VladimirMukhin21/Totoshka/Arduino MEGA распиновка.jpg

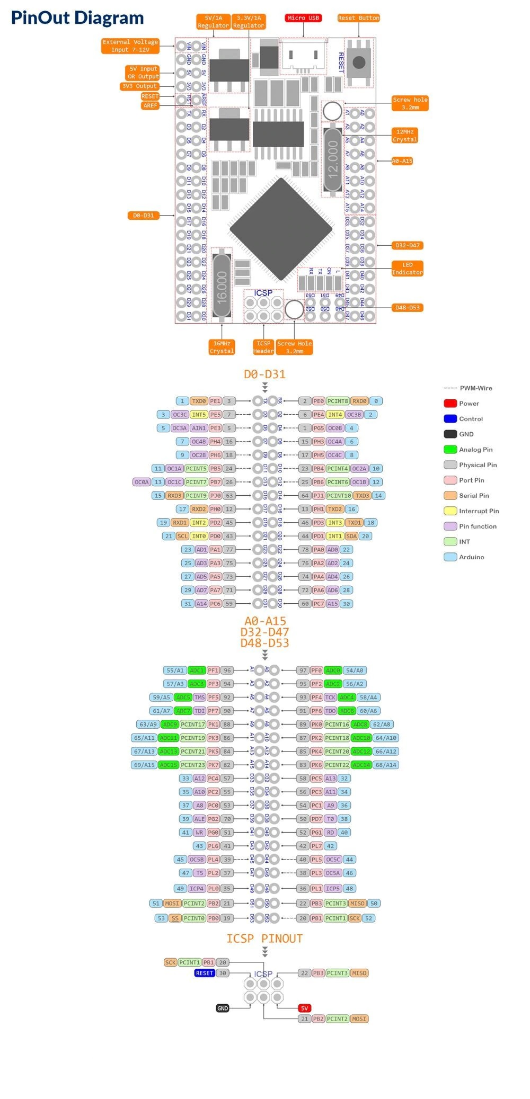
Arduino MEGA распиновка.jpg
