VladimirMukhin21/Totoshka/Инструменты с собой/IMG_20221014_193917.jpg

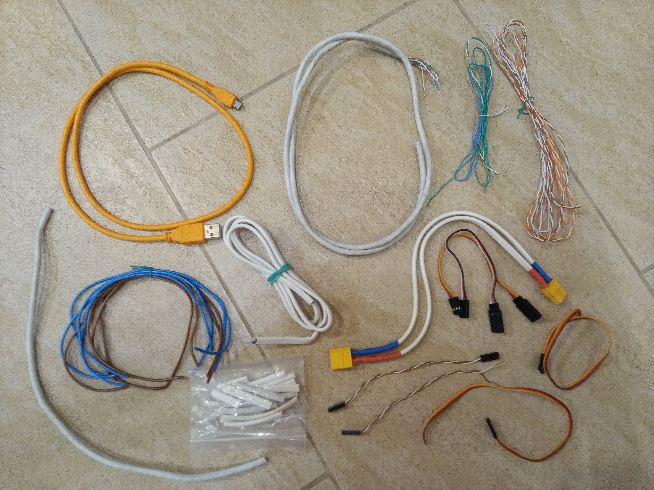
Инструменты с собой/IMG_20221014_193917.jpg
