VladimirMukhin21/Totoshka/src/Camera/samples/amox.png

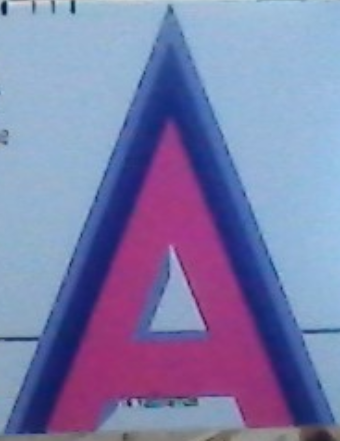
src/Camera/samples/amox.png
