VladimirMukhin21/Totoshka/src/Camera/samples/left.png

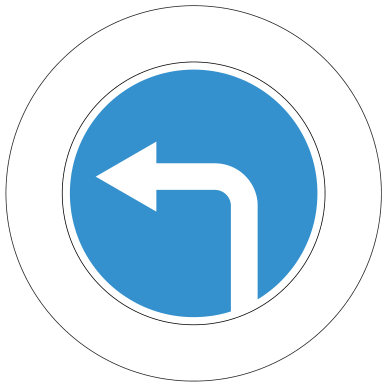
src/Camera/samples/left.png
