VladimirMukhin21/Totoshka/src/Camera/samples/right.png

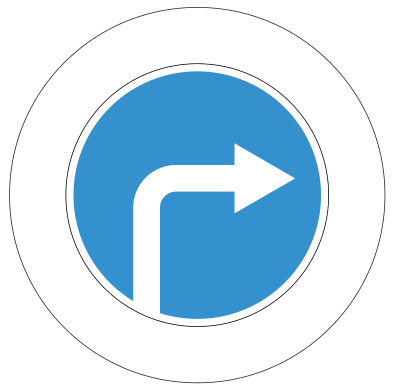
src/Camera/samples/right.png
