VladimirMukhin21/Totoshka/src/Camera/samples/stop.png

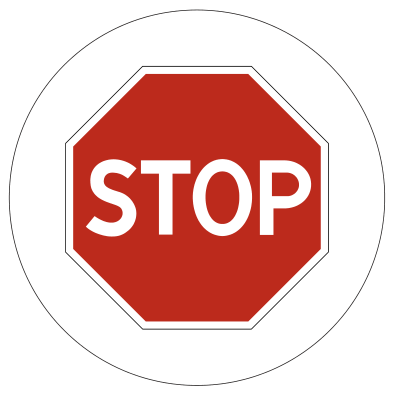
src/Camera/samples/stop.png
