VladimirMukhin21/Totoshka/src/traffic-signs/all.png

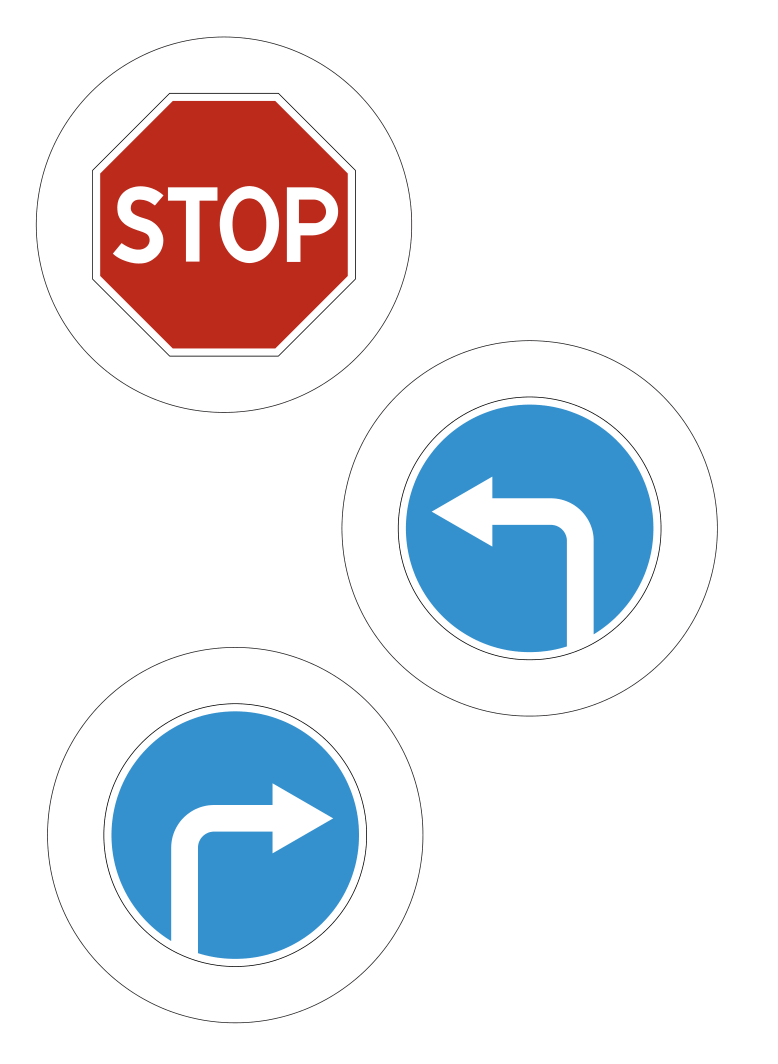
src/traffic-signs/all.png
