VladimirMukhin21/Totoshka/src/traffic-signs/left-for-detect.png

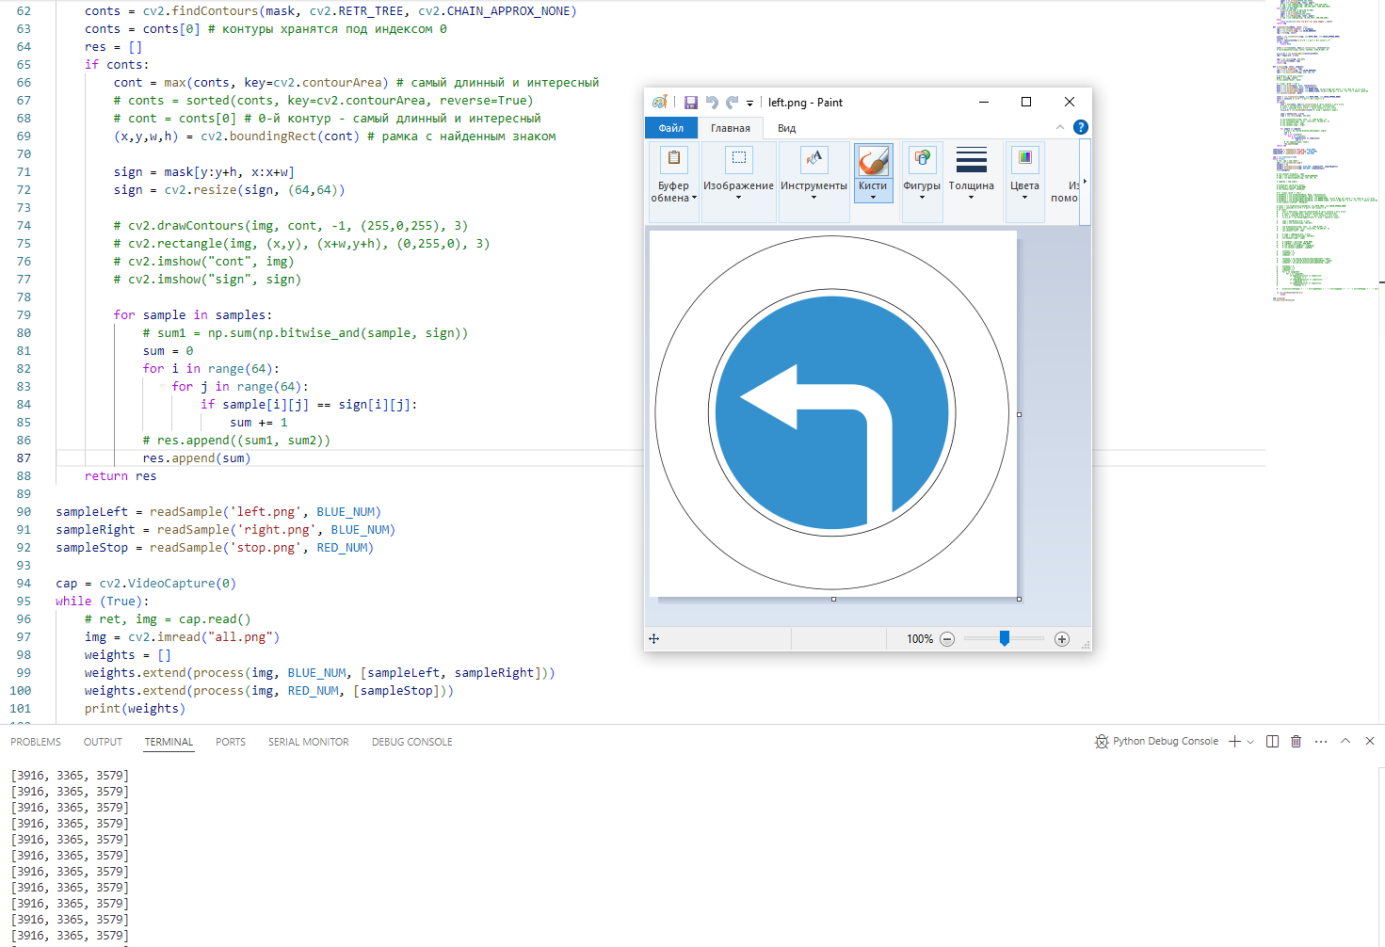
src/traffic-signs/left-for-detect.png
