VladimirMukhin21/Totoshka/Инструменты с собой/IMG_20211210_194941.jpg

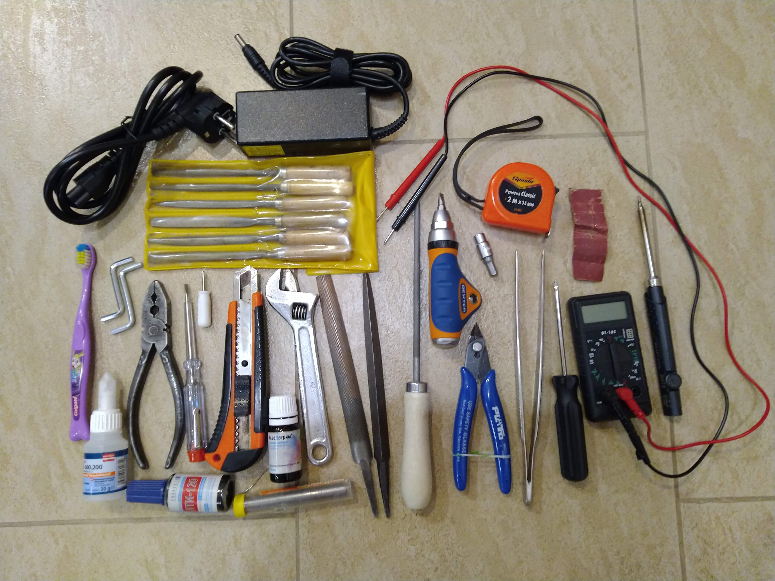
Инструменты с собой/IMG_20211210_194941.jpg
