VladimirMukhin21/Totoshka/Инструменты с собой/IMG_20211210_200247.jpg

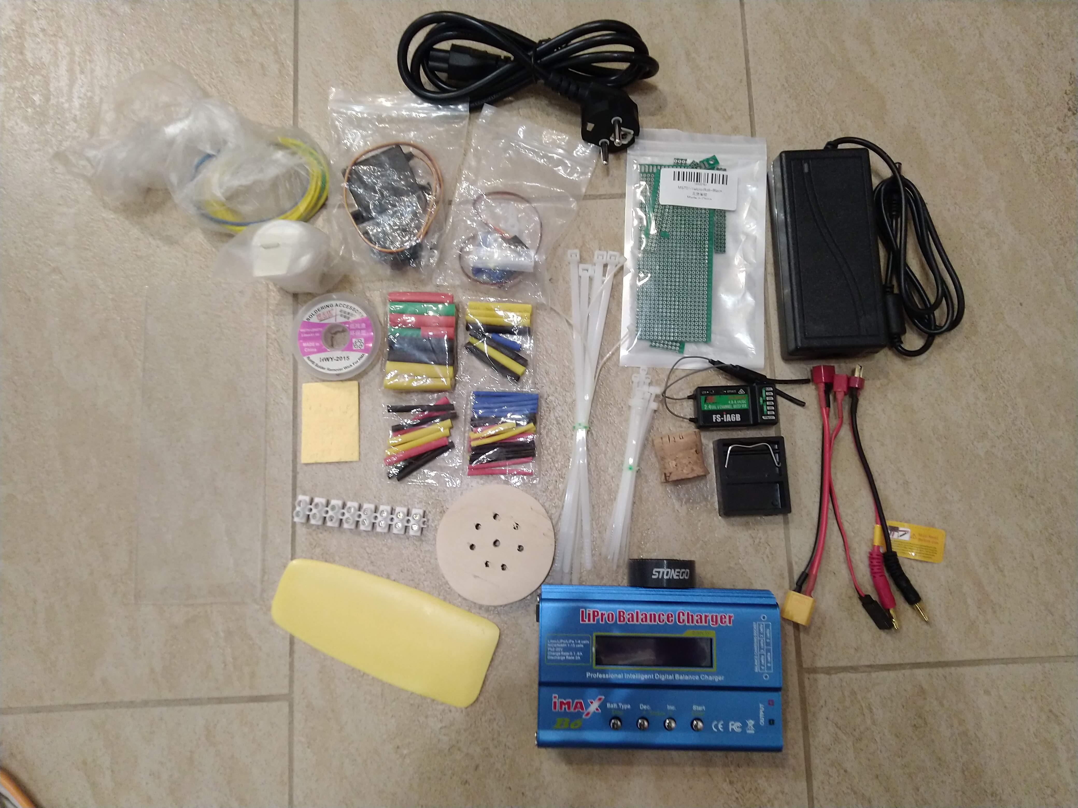
Инструменты с собой/IMG_20211210_200247.jpg
