VladimirMukhin21/Totoshka/Инструменты с собой/IMG_20211210_202206.jpg

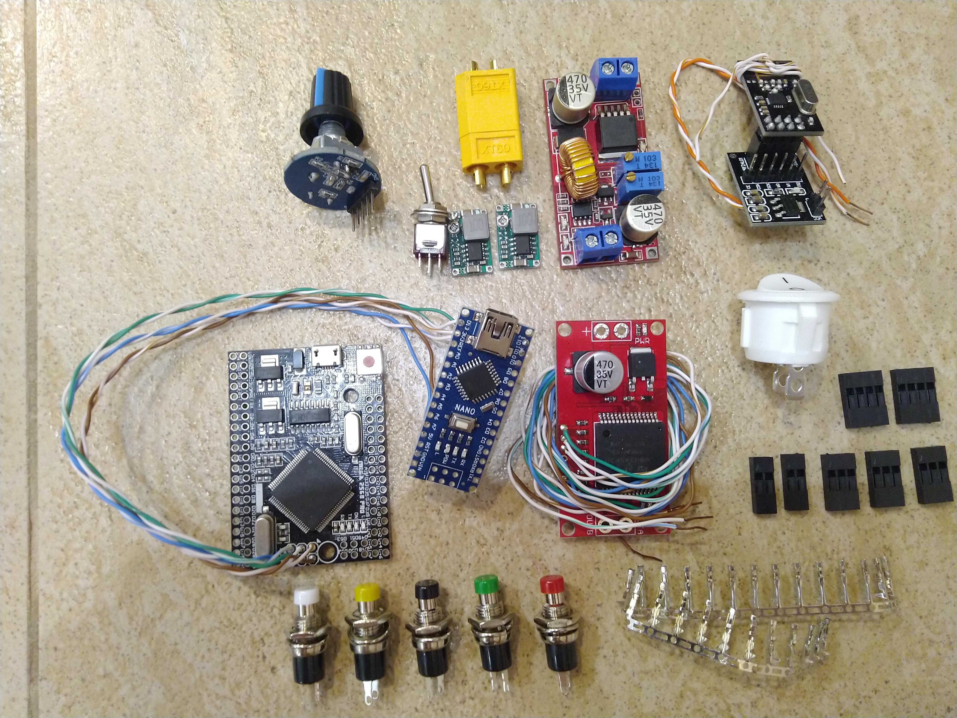
Инструменты с собой/IMG_20211210_202206.jpg
