VladimirMukhin21/Totoshka/Инструменты с собой/IMG_20211210_204245.jpg

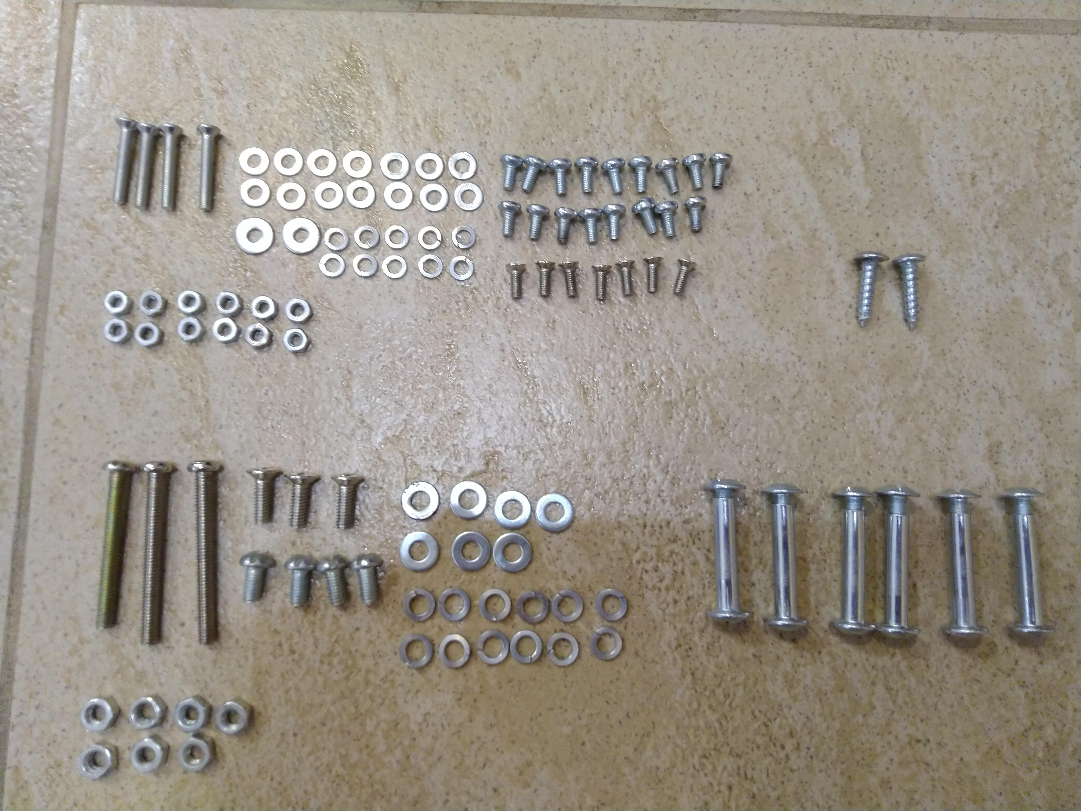
Инструменты с собой/IMG_20211210_204245.jpg
