VladimirMukhin21/Totoshka/Инструменты с собой/IMG_20211210_204258.jpg

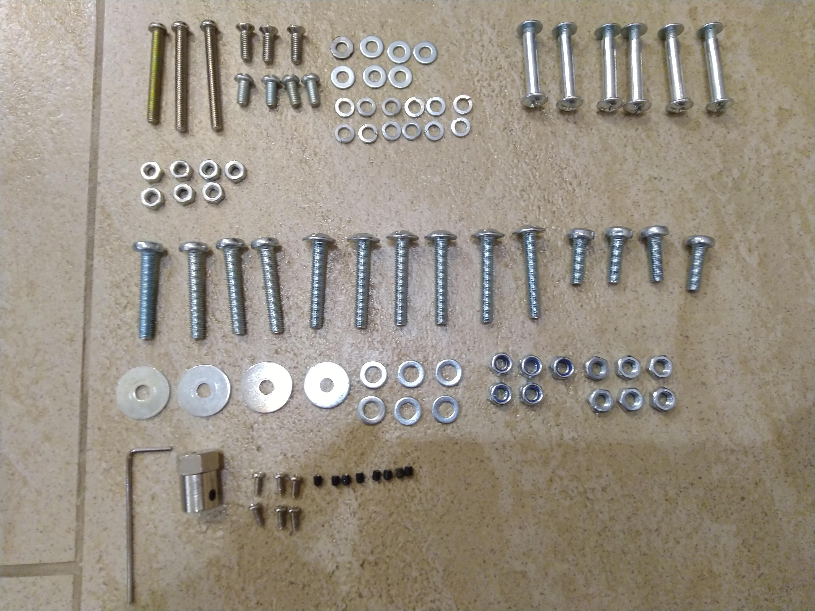
Инструменты с собой/IMG_20211210_204258.jpg
