VladimirMukhin21/Totoshka/Инструменты с собой/IMG_20221014_192934.jpg

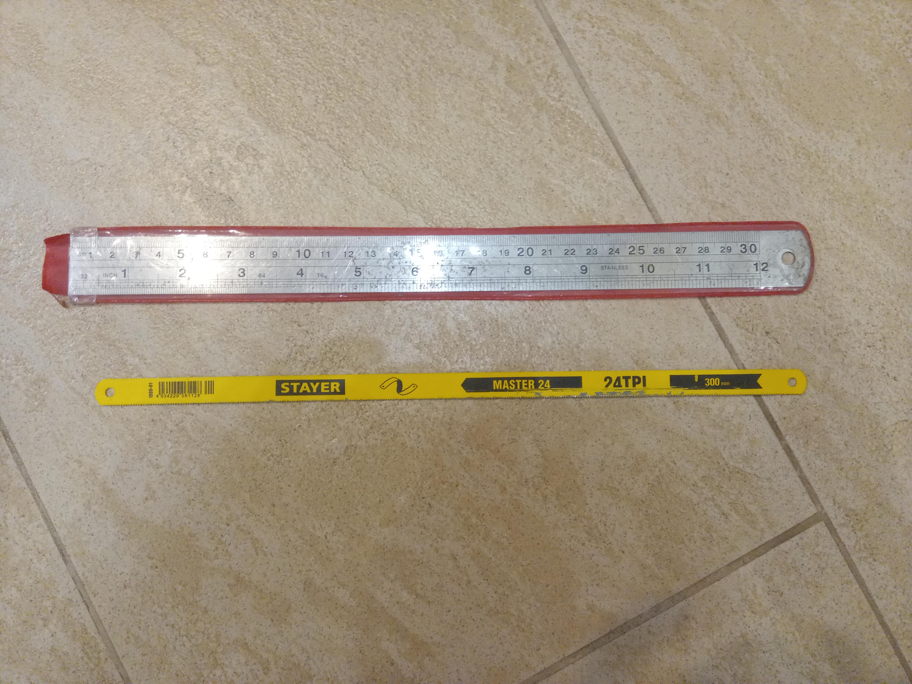
Инструменты с собой/IMG_20221014_192934.jpg
