VladimirMukhin21/Totoshka/Инструменты с собой/IMG_20221014_202028.jpg

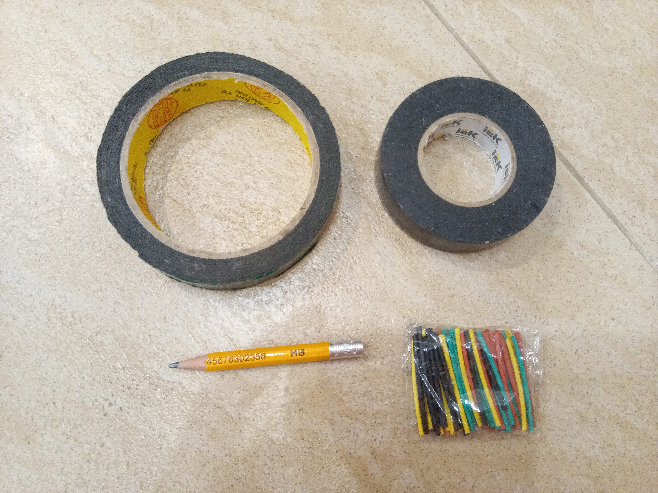
Инструменты с собой/IMG_20221014_202028.jpg
