VladimirMukhin21/Totoshka/Инструменты с собой/IMG_20221014_202440.jpg

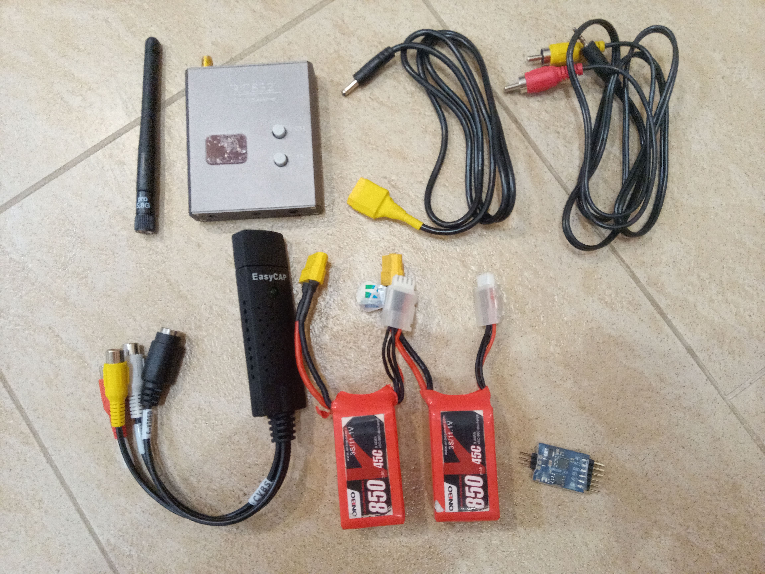
Инструменты с собой/IMG_20221014_202440.jpg
