VladimirMukhin21/Totoshka/Инструменты с собой/IMG_20221129_160802.jpg

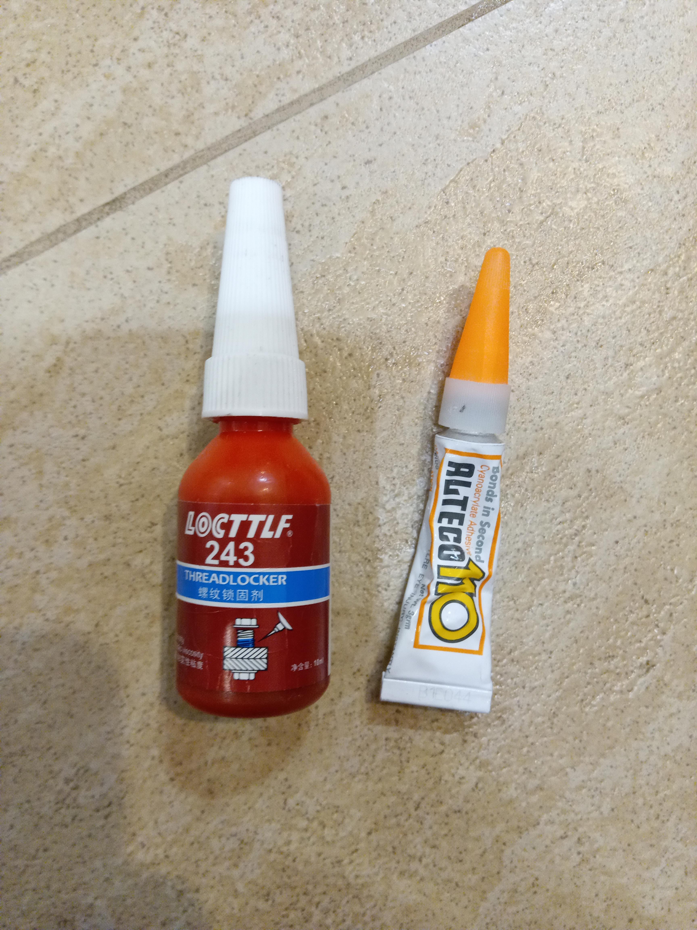
Инструменты с собой/IMG_20221129_160802.jpg
