VladimirMukhin21/Totoshka/Расчет робота.xlsx

Sheet: Лист1
Диаметр колеса, мм | 75 | 100 | 125 | 130
Длина окружности колеса, м | 0.235 | 0.314 | 0.393 | 0.408
Скорость рабочая
Скорость, м/с | 0.40 | 0.40 | 0.40 | 0.40
Скорость, м/мин | 24 | 24 | 24 | 24
Обороты вала, об/мин | 101.910828 | 76.43312102 | 61.14649682 | 58.79470848
Скорость минимальная
Скорость, м/с | 0.01 | 0.01 | 0.01 | 0.01
Скорость, м/мин | 0.60 | 0.60 | 0.60 | 0.60
Обороты вала, об/мин | 2.5 | 1.9 | 1.5 | 1.5
Скорость максимальная
Скорость, м/с | 0.75 | 0.75 | 0.75 | 0.75
Скорость, м/мин | 45 | 45 | 45 | 45
Обороты вала, об/мин | 191.0828025 | 143.3121019 | 114.6496815 | 110.2400784
Масса робота, кг | 5.4 | 5.4 | 5.4 | 5.4
Запас по мощности | 20% | 20% | 20% | 20%
Крутящий момент (3 двиг), кг*см | 8.1 | 10.8 | 13.5 | 14.0 | при жесткой подвеске робот будет касаться только 3-мя колесами
Крутящий момент (4 двиг), кг*см | 6.1 | 8.1 | 10.1 | 10.5
Крутящий момент (6 двиг), кг*см | 4.0 | 5.4 | 6.8 | 7.0

Sheet: Лист2
+ | Серва 60кг со скобами
+ | Серва 25кг 2шт со скобами
+ | Серва 15кг 2шт
+ | ATmega2560 2шт
+ | nNRF24L01 с антенной 2шт + стабилизатор питания
+ | Джойстик 2шт
+ | Энкодер
+ | Кпопка
 | линия 3шт
 | дальномер
 | Акселерометр-гироскоп
- | столбики
+ | регулятор питания
+ | макетная плата
- | провода мягкие
 | коробка для пульта и робота

Sheet: Пины
Распиновка Mega Пульт |  |  |  |  |  |  |  |  |  |  |  | Общая шина +/-
подключено | цвет | пин | пин | цвет | подключено | подключено | цвет | пин | пин | цвет | подключено | подключено | + | - | подключено | - | подключено
 |  | D1 tx | D0 rx |  |  |  |  | A1 | A0 |  |  |  | + | - |  | -
 |  | D3~ | D2~ |  |  |  |  | A3 | A2 |  |  |  | + | - |  | -
 |  | D5~ | D4~ |  |  |  |  | A5 | A4 |  |  |  | + | - |  | -
 |  | D7~ | D6~ |  |  |  |  | A7 | A6 |  |  |  | + | - |  | -
 |  | D9~ | D8~ |  |  |  |  | A9 | A8 |  |  |  | + | - |  | -
 |  | D11~ | D10~ |  |  |  |  | A11 | A10 |  |  |  | + | - |  | -
 |  | D13~ | D12~ |  |  | джойстик лев верт | БЗ | A13 | A12 | БЗ | джойстик прав верт | джойстик прав | + | - | джойстик прав | -
 |  | D15 | D14 |  |  | джойстик лев гориз | З | A15 | A14 | З | джойстик прав гориз | джойстик лев | + | - | джойстик лев | -
KeyPad R3 | СЕР | D17 | D16 | СЕР | KeyPad R4 | джойстик-кнопка лев | О | D33 | D32 | О | джойстик-кнопка прав | Mega + NRF | + | - | Mega + NRF | - | зелёная кнопка
KeyPad R1 | СЕР | D19 | D18 | СЕР | KeyPad R2 |  |  | D35 | D34 |  |  | включатель питания | + | - | включатель питания | - | синяя кнопка
KeyPad C2 | СЕР | D21 | D20 | СЕР | KeyPad C1 |  |  | D37 | D36
KeyPad C4 | РОЗ | D23 | D22 | СЕР | KeyPad C3 |  |  | D39 | D38
фасад тумблер вверх | БС | D25 | D24 | О | фасад тумблер вниз |  |  | D41 | D40
фасад желт кнопка | БО | D27 | D26 | З | фасад красн кнопка |  |  | D43 | D42
фасад черн кнопка | БС | D29 | D28 | БК | фасад бел кнопка |  |  | D45~ | D44~
верх зелёная кнопка | БС | D31 | D30 | БС | верх синяя кнопка |  |  | D47 | D46~
 |  |  |  |  |  | NRF CSN | О | D49 | D48 | БО | NRF CE
 |  |  |  |  |  | NRF MO | З | D51 | D50 | БК | NRF MI
 |  |  |  |  |  |  |  | D53 | D52~ | БЗ | NRF SCK
Распиновка Mega Робот
подключено | цвет | пин | пин | цвет | подключено | подключено | цвет | пин | пин | цвет | подключено
 |  | D1 tx | D0 rx |  |  |  |  | A1 | A0
 |  | D3~ | D2~ | Ж | переключатель камер |  |  | A3 | A2
лев драйвер PWM | З | D5~ | D4~ | З | прав драйвер PWM |  |  | A5 | A4
HAND_CLAW_PIN | О | D7~ | D6~ | БК | серва верхней камеры |  |  | A7 | A6
HAND_ELBOW_PIN | З | D9~ | D8~ | БО | HAND_ROTATE_PIN |  |  | A9 | A8
HAND_SHOULDER_PIN | БЗ | D11~ | D10~ | З | TAIL_COCCYX_PIN |  |  | A11 | A10
 |  | D13~ | D12~ | БС | серва передней камеры |  |  | A13 | A12
 |  | D15 | D14 |  |  |  |  | A15 | A14
 |  | D17 | D16 |  |  |  |  | D33 | D32
 |  | D19 | D18 |  |  |  |  | D35 | D34
гироскоп SCL | З | D21 | D20 | БЗ | гироскоп SDA |  |  | D37 | D36
 |  | D23 | D22 |  |  | прав драйвер EN | БК | D39 | D38 | БК | лев драйвер EN
 |  | D25 | D24 |  |  | прав драйвер INA | БЗ | D41 | D40 | БЗ | лев драйвер INA
 |  | D27 | D26 |  |  | прав драйвер INB | БС | D43 | D42 | БС | лев драйвер INB
датчик цвета лев SCL | О | D29 | D28 | БО | датчик цвета лев SDA |  |  | D45 | D44
датчик цвета прав SCL | З | D31 | D30 | БЗ | датчик цвета прав SDA |  |  | D47 | D46
 |  |  |  |  |  | NRF CSN | О | D49 | D48 | БО | NRF CE
 |  |  |  |  |  | NRF MO | З | D51 | D50 | БК | NRF MI
 |  |  |  |  |  | LED датчиков цвета | БС | D53 | D52~ | БЗ | NRF SCK
Распиновка Nano-программатор |  |  |  |  |  | ICSP
подключено | цвет | пин | пин | цвет | подключено | подключено | цвет | пин | пин | цвет | подключено
 |  | TX1 | D13 | БЗ | SCK программатор | MI программатор | БК | MI | 5V | К
 |  | RX0 | A0 |  |  | SCK программатор | БЗ | SCK | MO | З | MO программатор
 |  | D2 | A1 |  |  | RST программатор | БС | RST | GND | С
 |  | D3 | A2
 |  | D4 | A3
 |  | D5 | A4
 |  | D6 | A5
 |  | D7 | A6
 |  | D8 | A7
 |  | D9
RST программатор | БС | D10
MO программатор | З | D11
MI программатор | БК | D12
