VladimirMukhin21/Totoshka/src/Robot/Robot.ino

#include "Radio.h"
#include "Truck.h"
#include "Hand.h"
#include "Tail.h"
#include "Video.h"
#include "Average.h"
#include "Color.h"
#include "Gyro.h"
#include "DistMeter.h"
#include "ProgStairsUp.h"
#include "ProgStairsDown.h"
#include "ProgAutoLine.h"
#include "ProgTakeTin.h"
#include "ProgRotatePipe.h"
#include "ProgHillWithPipes.h"
#include "ProgHillWithPipesAutoTin.h"
#include "ProgTruncatedPyramid.h"
#include "ProgHoof.h"
#include "ProgCorridor.h"
#include "ProgBoard.h"

#define L_EN_PIN 38
#define L_INA_PIN 40  // 41
#define L_INB_PIN 42  // 43
#define L_PWM_PIN 5   // ШИМ

#define R_EN_PIN 39
#define R_INA_PIN 41  // 40
#define R_INB_PIN 43  // 42
#define R_PWM_PIN 4   // ШИМ

// shoulder - elbow - rotate - claw
#define HAND_SHOULDER_PIN 11
#define HAND_ELBOW_PIN 9
#define HAND_ROTATE_PIN 8
#define HAND_CLAW_PIN 7

#define TAIL_COCCYX_PIN 10

#define CAMERA_SWITCHER_PIN 2
#define CAMERA_FRONT_PIN 12
#define CAMERA_TOP_PIN 6

#define LED_PIN 13

Radio radio;
Truck truck;
Hand hand;
Tail tail;
Video video;
Color color;
Gyro gyro;
DistMeter distMeter;
ProgStairsUp progStairsUp;
ProgStairsDown progStairsDown;
ProgAutoLine progAutoLine;
ProgTakeTin progTakeTin;
ProgRotatePipe progRotatePipe;
ProgHillWithPipes progHillWithPipes;
ProgHillWithPipesAutoTin progHillWithPipesAutoTin;
ProgTruncatedPyramid progTruncatedPyramid;
ProgHoof progHoof;
ProgCorridor progCorridor;
ProgBoard progBoard;

unsigned long lastRadioTime = millis();

unsigned long changeLedTime = millis();
bool ledStatus = true;

void setup() {
  Serial.begin(9600);

  // Эта строка устраняет зависание робота из-за гироскопа. Источник решения:
  // https://github.com/jrowberg/i2cdevlib/issues/519#issuecomment-752023021
  // Судя из описания метода setWireTimeout, это крайняя мера и лучше искать истинную проблему:
  // https://www.arduino.cc/reference/en/language/functions/communication/wire/setwiretimeout/
  // Другое решение говорит, что надо подключить пин AD0 гироскопа к GND:
  // https://www.i2cdevlib.com/forums/topic/414-freezing-problem/
  Wire.setWireTimeout(3000, true);

  radio.initReceiver(distMeter, color);
  color.init();
  gyro.init();
  distMeter.init();
  truck.init(L_EN_PIN, L_INA_PIN, L_INB_PIN, L_PWM_PIN, R_EN_PIN, R_INA_PIN, R_INB_PIN, R_PWM_PIN, gyro, tail);
  hand.init(HAND_SHOULDER_PIN, HAND_ELBOW_PIN, HAND_ROTATE_PIN, HAND_CLAW_PIN);
  tail.init(TAIL_COCCYX_PIN);
  video.init(CAMERA_SWITCHER_PIN, CAMERA_FRONT_PIN, CAMERA_TOP_PIN);

  progStairsUp.init(truck, tail);
  progStairsDown.init(truck, tail);
  progAutoLine.init(truck, hand, color);
  progTakeTin.init(truck, hand, distMeter);
  progRotatePipe.init(hand);
  progHillWithPipes.init(truck, tail);
  progHillWithPipesAutoTin.init(truck, tail, hand, distMeter);
  progTruncatedPyramid.init(truck);
  progHoof.init(truck);
  progCorridor.init(truck, distMeter);
  progBoard.init(truck);

  pinMode(LED_PIN, OUTPUT);
}

void loop() {
  if (!radio.available()) {
    if (millis() - lastRadioTime > 500) {
      stopAll();
      digitalWrite(LED_PIN, HIGH);
    }

    return;
  }

  //digitalWrite(LED_PIN, LOW);
  lastRadioTime = millis();

  Payload payload = radio.read();

  if (payload.frontRedButton) {
    stopAll();
    return;
  }

  tickAll();

  // мигаем светодиодом если не подвисли
  if (millis() - changeLedTime >= 500) {
    changeLedTime = millis();
    ledStatus = !ledStatus;
    digitalWrite(LED_PIN, ledStatus);
  }

  video.setActiveCamera(payload.frontBlackButtonSwitch);  // Переключение между камерами

  // если какая-то программа запущена, то роботом не управляем с пульта
  if (isAnyProgRunning()) {
    return;
  }

  if (payload.frontSwitch == 0) {
    if (payload.upGreenButton) {  // Рука на спину
      hand.handToBack();
    }
    else if (!payload.upBlueButton) {
      hand.operate(payload.leftStick.vert, payload.leftStick.horiz, 1, 0);  // altMode
    }
  }
  else if (payload.frontSwitch == 1) {
    if (payload.upGreenButton) {  // Рука на спину
      hand.handToBack();
    }
    else if (payload.leftStick.pressed) {  // Управление плечом
      hand.operate(payload.leftStick.vert, payload.leftStick.horiz, 0, 1);
    }
    else if (!payload.upBlueButton) {
      hand.operate(payload.leftStick.vert, payload.leftStick.horiz, 0, 0);  // НЕ altMode и НЕ управление плечом
    }
  }
  else if (payload.frontSwitch == 2) {
    if (payload.upGreenButton) {  // Хвост наверх
      tail.upTail();
    }
    else if (!payload.upBlueButton) {
      tail.operate(payload.leftStick.vert);
    }
  }

  if (payload.upBlueButton) {
    video.moveCamera(payload.leftStick.vert);  // Поворот камеры

    if (payload.upGreenButton) {  // Рука наверх
      hand.handToUp();
    }

    if (payload.frontYellowButton) {  // Захват маяка
      progTakeTin.start();
      return;
    }

    if (payload.key == 0xA1) {  // Езда прямо
      truck.goStraight(180);
      return;
    }
    else if (payload.key == 0xB1) {  // Езда прямо медленно
      truck.goStraight(70);
      return;
    }
    else if (payload.key == 0xC1) {  // Езда прямо задом
      truck.goStraight(-180);
      return;
    }
    else if (payload.key == 0xD1) {  // Езда прямо задом медленно
      truck.goStraight(-60);
      return;
    }
    else if (payload.key == 0xA2) {  // Рука на линию
      hand.handToRideTheLine();
    }
    else if (payload.key == 0xB2) {  // Авто-линия
      progAutoLine.start();
      return;
    }
    else if (payload.key == 0xC2) {          // Подъем по наклонной
      truck.goHillUp(200, 4000, 1000, 100);  // едем быстро
      return;
    }
    else if (payload.key == 0xD2) {  // Спуск по наклонной
      truck.goHillDown(100);         // едем медленно
      return;
    }
    else if (payload.key == 0xA3) {  // Поворот трубки
      progRotatePipe.start();
      return;
    }
    else if (payload.key == 0xB3) {  // Горка с трубами налево
      progHillWithPipes.start(-90);
      return;
    }
    else if (payload.key == 0xC3) {  // Горка с трубами прямо
      progHillWithPipes.start(0);
      return;
    }
    else if (payload.key == 0xD3) {  // Горка с трубами направо
      progHillWithPipes.start(90);
      return;
    }
    else if (payload.key == 0xA4) {  // Подъем по лестнице
      progStairsUp.start();
      return;
    }
    else if (payload.key == 0xB4) {  // Поворот влево на 90 град
      truck.turn(-90);
      return;
    }
    else if (payload.key == 0xC4) {  // Поворот вправо на 90 град
      truck.turn(90);
      return;
    }
    else if (payload.frontWhiteButton && payload.key == 0xD4) {  // Калибровка гироскопа
      // хвостом показываем, что калибровка началась
      tail.moveTo(0);
      for (int i = 0; i < 100; i++) {
        tail.tick();
        delay(2);
      }

      delay(500);  // ждем, чтобы все успокоилось после движения хвоста
      gyro.calibrate();

      // хвостом показываем, что калибровка завершилась
      tail.moveTo(180);
      for (int i = 0; i < 100; i++) {
        tail.tick();
        delay(2);
      }

      return;
    }
  }

  if (payload.frontWhiteButton) {
    if (payload.key == 0xA1) {  // Коридор налево
      progCorridor.start(ProgCorridor::TURN_LEFT);
      return;
    }
    else if (payload.key == 0xB1) {  // Коридор направо
      progCorridor.start(ProgCorridor::TURN_RIGHT);
      return;
    }
    else if (payload.key == 0xC1) {  // Рука на вращение нижних вентилей нефти
      hand.handToLowOil();
    }
    else if (payload.key == 0xD1) {  // Рука на вращение верхних вентилей нефти
      hand.handToHighOil();
    }
    else if (payload.key == 0xA2) {  // Доска
      progBoard.start();
      return;
    }
    else if (payload.key == 0xB2) {  // Провалы налево
      progTruncatedPyramid.start(-90);
      return;
    }
    else if (payload.key == 0xC2) {  // Провалы прямо
      progTruncatedPyramid.start(0);
      return;
    }
    else if (payload.key == 0xD2) {  // Провалы направо
      progTruncatedPyramid.start(90);
      return;
    }
    else if (payload.key == 0xA3) {  // Рука на вращение среднего слоя 6-ти гранных трубок
      hand.handToRotatePipe();
    }
    else if (payload.key == 0xB3) {  // Горка с трубами с захватом маяка налево
      progHillWithPipesAutoTin.start(-90);
      return;
    }
    else if (payload.key == 0xC3) {  // Горка с трубами с захватом маяка прямо
      progHillWithPipesAutoTin.start(0);
      return;
    }
    else if (payload.key == 0xD3) {  // Горка с трубами с захватом маяка направо
      progHillWithPipesAutoTin.start(90);
      return;
    }
    else if (payload.key == 0xA4) {  // Копыто налево
      progHoof.start(-60);
      return;
    }
    else if (payload.key == 0xB4) {  // Копыто направо
      progHoof.start(60);
      return;
    }
    else if (payload.key == 0xC4) {  // рестарт датчика расстояния
      distMeter.disable();
      delay(50);
      distMeter.enable();
    }
    else if (payload.key == 0xD4) {  // Калибровка гироскопа
      // не занимать! тут калибровка гироскопа на син + бел + D4
    }
  }

  truck.operate(payload.rightStick.vert, payload.rightStick.horiz);
}

bool isAnyProgRunning() {
  return progStairsUp.isRunning()
         || progStairsDown.isRunning()
         || progAutoLine.isRunning()
         || progTakeTin.isRunning()
         || progRotatePipe.isRunning()
         || progHillWithPipes.isRunning()
         || progHillWithPipesAutoTin.isRunning()
         || progTruncatedPyramid.isRunning()
         || progHoof.isRunning()
         || progCorridor.isRunning()
         || progBoard.isRunning();
}

void stopAll() {
  truck.stop(Motor::SMOOTH_OFF);
  hand.stop();
  tail.stop();
  video.stop();
  progStairsUp.stop();
  progStairsDown.stop();
  progAutoLine.stop();
  progTakeTin.stop();
  progRotatePipe.stop();
  progHillWithPipes.stop();
  progHillWithPipesAutoTin.stop();
  progTruncatedPyramid.stop();
  progHoof.stop();
  progCorridor.stop();
  progBoard.stop();
}

void tickAll() {
  truck.tick();
  hand.tick();
  tail.tick();
  video.tick();
  gyro.tick();
  progStairsUp.tick();
  progStairsDown.tick();
  progAutoLine.tick();
  progTakeTin.tick();
  progRotatePipe.tick();
  progHillWithPipes.tick();
  progHillWithPipesAutoTin.tick();
  progTruncatedPyramid.tick();
  progHoof.tick();
  progCorridor.tick();
  progBoard.tick();
}
