VladimirMukhin21/Totoshka/src/Robot/Tail.h

#pragma once

#include <Servo.h>
#include "Angle.h"

class Tail {
public:
  void init(byte coccyxPin);
  void operate(byte stickVert);
  void moveTo(int deg, bool returnAfter = false);
  void upTail(bool returnAfter = false);
  void downTail(bool returnAfter = false);
  void stop();
  void tick();
  bool isRunning();

private:
  const byte _minStick = 0;
  const byte _maxStick = 255;
  const byte _maxSpeed = 5;
  static const int UP_ANGLE = 139;
  static const int DOWN_ANGLE = 15;

  Servo _coccyx;

  Angle _coccyxAngle = Angle(UP_ANGLE, DOWN_ANGLE, UP_ANGLE, 40); // 40 - быстрая скорость, 50 - медленная // вниз-вверх; макс вверх для больших колес - 140, для маленьких - 145

  //#define DEBUG
#ifdef DEBUG
  unsigned long _printTime = millis();
#endif

  unsigned long _tickTime = millis();
  int _targetDeg;
  int _returnAngle = 0;
  bool _returnAfter = false;
  bool _isRunning = false;

  byte filterStickDeadZone(byte value);
};

void Tail::init(byte coccyxPin) {
  _coccyx.attach(coccyxPin);
  _coccyx.write(_coccyxAngle.toDeg());
}

void Tail::operate(byte stickVert) {
  int speedVert = map(filterStickDeadZone(stickVert), _minStick, _maxStick + 1, -_maxSpeed, _maxSpeed + 1);
  if (speedVert != 0) {
    _isRunning = false;

    _coccyxAngle.addPoints(speedVert);
    _coccyx.write(_coccyxAngle.toDeg());
  }

  /*#ifdef DEBUG
  if (millis() - _printTime >= 1000) {
    _printTime = millis();
    Serial.print("stick = ");
    Serial.print(stickVert);
    Serial.print("\tangle = ");
    Serial.print(_coccyxAngle.toDeg());
    Serial.print("\tspeed = ");
    Serial.print(speedVert);
    Serial.println();
  }
#endif*/
}

void Tail::moveTo(int deg, bool returnAfter = false) {
  _targetDeg = deg;
  _isRunning = true;

  _returnAfter = returnAfter;
  if (_returnAfter) {
    _returnAngle = _coccyxAngle.toDeg();
  }
}

void Tail::upTail(bool returnAfter = false) {
  moveTo(UP_ANGLE, returnAfter);
}

void Tail::downTail(bool returnAfter = false) {
  moveTo(DOWN_ANGLE, returnAfter);
}

void Tail::stop() {
  _isRunning = false;
}

void Tail::tick() {
  if (!_isRunning) {
    return;
  }

  if (millis() - _tickTime >= 1) {
    _tickTime = millis();

    int delta = _targetDeg - _coccyxAngle.toDeg();
    if (delta != 0) {
      _coccyxAngle.addPoints(constrain(delta, -5, 5));
      _coccyx.write(_coccyxAngle.toDeg());
    }
    else {
      if (_returnAfter) {
        moveTo(UP_ANGLE);  //_returnAngle);
        _returnAfter = false;
      }
      else {
        _isRunning = false;
      }
    }
  }
}

bool Tail::isRunning() {
  return _isRunning;
}

byte Tail::filterStickDeadZone(byte value) {
  if (value > 88 && value < 168)
    return 128;
  else
    return value;
}
