VladimirMukhin21/Totoshka/src/Robot/ProgHoof.h

#pragma once

#include "Truck.h"

class ProgHoof {
public:
  void init(Truck &truck);
  void start(int turnOnTopAngleDeg);
  void stop();
  void tick();
  bool isRunning();

private:
  enum Phase {
    NONE,
    STARTING,
    DRIVE_TOP,
    TURN1,
    LITTLE_DRIVE,
    TURN2,
    DRIVE_DOWN,
    STOP
  };

  const int _driveSpeed = 100;
  const int _slowDriveSpeed = 50;

  Truck *_truck;
  Phase _phase = NONE;
  int _turnOnTopAngleDeg = 0;
};

void ProgHoof::init(Truck &truck) {
  _truck = &truck;
}

void ProgHoof::start(int turnOnTopAngleDeg) {
  if (isRunning()) {
    return;
  }

  _turnOnTopAngleDeg = turnOnTopAngleDeg;
  _phase = STARTING;
}

void ProgHoof::stop() {
  _truck->stop();
  _phase = NONE;
}

void ProgHoof::tick() {
  if (_phase == NONE) {
    return;
  }
  else if (_phase == STARTING) {
    // программа стартует => заезжаем на вершину
    _truck->goHillUp(_driveSpeed, 6000, 1800, 30);
    _phase = DRIVE_TOP;
  }
  else if (_phase == DRIVE_TOP) {
    if (!_truck->isRunning()) {
      // на вершину заехали => поворачиваем на 45 градусов
      _truck->turn(_turnOnTopAngleDeg);
      _phase = TURN1;
    }
  }
  else if (_phase == TURN1) {
    if (!_truck->isRunning()) {
      // повернули => еще чуть-чуть подъезжаем
      _truck->autoGo(_slowDriveSpeed, 800);
      _phase = LITTLE_DRIVE;
    }
  }
  else if (_phase == LITTLE_DRIVE) {
    if (!_truck->isRunning()) {
      // на вершину заехали => еще доворачиваем на 45 градусов
      _truck->turn(_turnOnTopAngleDeg);
      _phase = TURN2;
    }
  }
  else if (_phase == TURN2) {
    if (!_truck->isRunning()) {
      // повернули => на маленькой скорости съезжаем прямо
      _truck->goHillDown(_slowDriveSpeed, -4000, -1000, 50);
      _phase = DRIVE_DOWN;
    }
  }
  else if (_phase == DRIVE_DOWN) {
    if (!_truck->isRunning()) {
      // доехали до горизонтали => еще немного отъезжаем
      _truck->autoGo(_driveSpeed, 500);
      _phase = STOP;
    }
  }
  else if (_phase == STOP) {
    if (!_truck->isRunning()) {
      // отъехали => стоп
      stop();
    }
  }
}

bool ProgHoof::isRunning() {
  return _phase != NONE;
}
