VladimirMukhin21/Totoshka/(commit log)

2022-04-03 Начальный коммит программы робота и пульта.
2022-04-03 Добавлена папка с тестами.
2022-04-03 Добавлена программа установки сервы в центральное положение.
2022-04-03 Добавлена папка с библиотеками.
2022-04-03 Удаление ошибочно добавленного репозитория.
2022-04-03 Добавление библиотек i2cdevlib.
2022-04-03 Добавлена программа измерения расстояния лазерным дальномером.
2022-04-03 Перемещение библиотек.
2022-04-03 Добавление тестового скетча для гироскопа и лазерного дальномера.
2022-04-03 Добавлено среднее значение для лазерного дальномера.
2022-04-03 Улучшен алгоритм вычисления среднего значения.
2022-04-03 Добавлена функция reset.
2022-04-03 Добавлено среднее значение для гироскопа.
2022-04-07 Удалено лишнее из программы.
2022-04-09 Добавлены файлы с распиновкой Arduino MEGA, инструментами и расчет робота.
    [Расчет робота.xlsx]
2022-04-09 Добавлены классы для езды прямо.
2022-04-10 Перенесено снятие показаний с гироскопа в Gyro и исправлены ошибки в программе.
    [Gyro.h]
2022-04-10 Добавлена функция tick в Gyro, запуск программы кнопкой и убраны фазы в GoStraight.
2022-04-10 Добавлена девиация.
2022-04-10 Выделен метод goAndTurn.
2022-04-10 Если работает progGoStraight, то отключаем джойстик (иначе робот дергается). Возможно, аналогично надо сделать и для программ лестниц.
2022-04-10 Добавлена калибровка под комментарием.
2022-04-10 Учет девиации при езде прямо.
2022-04-10 Теперь можно ехать и управлять наклоном камеры одновременно.
2022-04-10 Увеличена макс скорость разворота робота.
2022-04-10 При вычислении угла подворота робота делим девиацию на большее значение (было 1000, стало 10000).
2022-04-10 Выделил tickAll и перенес его после проверки связи и красной кнопки (стопа).
2022-04-10 Почистил лишнее.
2022-04-10 LED 13 теперь мигает когда программа работает штатно (и перестает мигать когда программа подвисает).
2022-05-10 Добавил библиотеку EncButton (источник: https://github.com/GyverLibs/EncButton).
2022-05-10 Черная кнопка теперь работает как двух-позиционный переключатель.
2022-05-10 Обновил Radio.h для робота (в соответствии с пультом).
2022-05-10 Отключил программу езды прямо по черной кнопке (черная кнопка теперь будет переключать камеры).
2022-05-10 Переключение между камерами и управление ими на роботе.
2022-05-10 Обновил назначение пинов.
    [Расчет робота.xlsx]
2022-05-10 Исправили ограничение высоты хвоста, чтобы не касался рамы.
    [Tail.h]
2022-05-10 Исправлен пин и изменен шим переключателя.
    [Robot.ino, Video.h]
2022-05-13 Исправил нулевое положение верхней камеры.
    [Video.h]
2022-05-16 Поменяли камеры местами при включении в переключатель.
2022-05-16 Ограничили угол подъема хвоста, чтобы не касался поворотного механизма верхней камеры.
2022-05-16 Подредактировали времена и скорость при подъеме по лестнице.
2022-05-16 Закомментировали использование гироскопа. Увеличили интервал отсутствия связи до стопа.
2022-07-23 Добавлены библиотеки для датчика цвета.
2022-07-23 Добавлена информация об используемых библиотеках.
2022-07-23 Добавлены пины датчика цвета.
    [Расчет робота.xlsx]
2022-07-23 Тест с двумя датчиками цвета.
2022-07-23 Добавлена езда по линии.
2022-07-23 Изменены пины и переменные правого и легого датчиков цвета.
2022-07-23 Добавлен пин от светодиодов датчиков цвета.
    [Расчет робота.xlsx]
2022-07-23 Добавлено включение и выключение светодиодов датчиков цвета.
2022-07-24 Исправлена фильтрация мёртвой зоны для тележки.
    [Motor.h, Truck.h]
2022-07-28 Добавлено умножение для правого датчика цвета для калибровки.
2022-07-30 Подключение GyverPID.
2022-07-30 Почистили лишнее.
2022-08-05 Изменено автоматическое поднятие руки по зелёной кнопке.
2022-08-06 Добавлено ограничение для руки в положении на спине.
2022-08-15 Изменен максимальный угол поворота хвоста.
2022-08-16 Изменен максимальный угол поворота серв руки и хвоста.
2022-11-27 Изменение стартового положения руки.
2022-11-27 Подбор параметров езды по линии (под комментарием).
2022-11-27 Добавлена библиотека GyverPID.
2022-11-27 Описание GyverPID в README.md.
2022-11-29 В Payload убрали указание сколько бит использовать под флаги (решили проблему со случайным стопом программы). В пульте переделали чтение кнопок на EncButton. Закомментировали печать в Serial (на всяк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
2022-12-01 Revert: В пульте переделали чтение кнопок на EncButton.
    [Console.ino]
2022-12-01 Включение программ только при зажатой синей кнопке (чтобы не включались случайно).
2023-06-01 Теперь рука при старте робота переходит в верхнее положение.
2023-08-09 Изменение езды по линии.
2023-08-09 Добавлено опускание руки для езды по линии.
2023-08-10 Изменены настройки для езды по линии.
2023-08-22 Изменены коэффициенты для датчика цвета.
2023-10-21 Изменено сжатие руки
2023-10-21 Изменены коэффициенты для езды по линии
2023-10-21 Добавлен python код для отображения камеры на ноуте. Прорисованы гайды.
2023-10-21 Печать захваченных QR-кодов на изображении.
2023-10-21 Поправил шрифт и надпись про QR-коды.
2023-10-24 Отображение текущего масштаба при зуммировании.
2023-10-29 Вынес номер камеры в константу. Добавил освобождение ресурсов в конце программы.
2023-10-29 Добавлена запись видео в файл.
2023-10-29 Вкл/выкл записи по shift-0.
2023-10-29 Показ справки.
2023-10-29 Батник для старта камеры.
2023-10-29 Настроены гайдлайны нижней камеры.
2023-10-31 Переключение режимов захвата qr-кода.
2023-10-31 Дополнил справку.
2023-11-02 Попытка распознавания qr-кода теперь выполняется не чаще, чем раз в 300мс.
2023-11-08 Beep при распознавании QR.
2023-11-14 Изменил способ интерполяции при масштабировании изображения (INTER_LINEAR лучше подходит для увеличения изображения).
2023-11-14 Перепаяли левый датчик цвета на пины 28/29 и осводили I2C, т.к. он конфликтовал по адресу с датчиком расстояния. Теперь датчик расстояния может работать.
    [Расчет робота.xlsx]
2023-11-15 Добавлен раздел Управление пультом.
2023-11-15 Автоматический захват маяка (первая реализация).
2023-11-16 Поправлены скорости и углы руки. Убран лишняя езда.
2023-11-16 Конструкция switch как-то странно работала (не переходила на следующую ветку), заменили на if-else.
2023-11-17 Переименование переменных.
2023-11-18 Добавлены гайдлайны для верхней камеры.
2023-11-18 Обновление библиотеки i2cdev - исправлен баг, из-за которого, похоже, зависал робот при работе гироскопа.
2023-11-18 Наладили работу гироскопа и езды прямо. Изменено назначение кнопок пульта (чтобы новые программы было куда назначить).
2023-11-19 Обновлен раздел про используемые библиотеки.
2023-11-19 Удалена отдельная программа езды прямо, логика перенесена в Truck.goStraight.
2023-11-19 Увеличены скорости руки и хвоста. Увеличена дистанция до банке при автозахвате. Уменьшена мертвая зона для верт. джойстика руки.
2023-11-19 В программе захвата маяка подъезд теперь выполняется по гироскопу.
2023-11-19 Добавлена программа поворот трубок.
2023-11-19 Установка руки на линию перенесена на тумблер-центр (было на тумблер-вниз).
2023-11-19 Добавлена калибровка гироскопа.
2023-11-21 Добавлены программы подъема/спуска по наклонной.
2023-11-21 Форматирование файлов.
2023-11-21 Изменили пороговые значения для руки и захвата маяка. При захвате маяка рука теперь может подниматься по 2-м сценариям.
2023-11-21 Замедление робота при подъезде к маяку.
2023-11-22 Изменены пороговые значения по умолчнию в методе подъема/спуска по наклонной.
2023-11-22 Изменены пороговые значения хвоста для маленьких колес.
2023-11-22 Старт программы подъема/спуска по наклонной.
2023-11-22 Обновлены фото инструментов с собой.
2023-11-22 В Gyro теперь считаем средние показания (а не моментальные). Еще надо по коду расставить вкд/выкл Gyro где надо, т.к. теперь в tick считываются показания!
2023-11-23 Добавлено авто включение/выключение гироскопа.
2023-11-24 Попытка сделать мягкий старт/стоп моторов. Посмотрим как будет работать.
2023-11-24 Добавлена библиотека Keypad (для матричной клавиатуры на пульте).
2023-11-24 Отлажен плавный старт/стоп тележки.
2023-11-25 Добавлены пины с KeyPad в пульт.
    [Расчет робота.xlsx]
2023-11-25 Добален класс ButtonPad в пульт.
2023-11-25 В "Захвате банки" отключено сглаживание при стопе и исправлена проблема "медленной" (из-за гироскопа) руки.
    [Gyro.h, Motor.h, ProgTakeTin.h, Truck.h]
2023-11-25 По красной кнопке делаем резкий стоп тележки.
2023-11-25 Увеличена скорость мягкого разгона/торможения. Увеличена жесткость стопа по умолчанию.
2023-11-25 Переименование ButtonPad -> Keyboard.
2023-11-25 Запуск программ с кейпада.
2023-11-25 Уменьшена скорость медленной езды прямо.
2023-11-25 Т.к. робот все время подворачивает влево, добавлено "подрезание" скорости правой оси.
2023-11-25 Исправлен подруливающий коэффициент при "езде прямо".
    [Truck.h]
2023-11-25 Отрегулирована скорость медленной "езды прямо".
2023-11-25 Исправлен раздел Управление пультом.
2023-11-25 Калибровка гироскопа по кнопке.
2023-11-25 Переименование программы авто-линии.
2023-11-25 Добавил недостающий include.
2023-11-25 Увеличена скорость подъема и уменьшена скорость спуска.
2023-11-25 Исправили ошибку записи/чтения оффсетов гироскопа (был разный тип сохраняемых/читаемых данных - int/long).
    [Gyro.h]
2023-11-25 Первая версия езды по горке с трубами.
2023-11-26 Добавлен авто поворот вправо на 90 град (пока не отлажен).
2023-11-26 Улучшены коэффициенты для Горки с трубами (но надо еще потестировать).
2023-11-26 Отладка поворота на 90 град (еще не работает, будем переходить на вычисление площади под функцией измерений).
2023-11-26 Класс Average теперь умеет считать немоментальные величины по методу конечных элементов (через площадь трапеции). Величины gx/gy/gz сделаны немоментальными.
2023-11-26 Подобран коэффициент для поворота на 90 град.
2023-11-26 Добавлена программа поворота влево на 90 град. Теперь в метод поворота на 90 град влево/вправо параметр указывается в градусах (а не у.е.).
2023-11-26 Добавлены программы Горка с трубами налево/направо.
2023-11-26 Добавлены программы для проезда Провалов (налево/прямо/направо).
2023-11-26 Добавлена программа Копыто (налево/направо).
2023-11-26 Исправлены кнопки программ в инструкции.
2023-11-26 Исправление перехода режима в Горке с трубами.
    [ProgHillWithPipes.h]
2023-11-26 В Gyro были напутаны флаги momentary. И оказалось, что вычисление площади трапеции не работает (возможно, переполнение, надо разобраться).
2023-11-26 Увеличена скорость медленного подъезда.
2023-11-26 Поправили коэффициенты и добавили подъезды.
2023-11-26 Если нажата белая кнопка, то тоже читаем keyboard.
2023-11-28 Настроили ПИД для езды по линии.
2023-11-28 Изменены коэффициенты для Горки с трубами.
2023-11-28 В Провалы добавлен финальный отъезд.
2023-11-28 Добавлено подталкивание хвостом при езде прямо вперед.
2023-11-28 Подъем/спуск разделены на разные программы (на полигоне после спуска есть небольшой подъем и надо останавливаться.
2023-11-28 В спуске/подъеме добавили небольшой доезд в конце для фиксации результата.
2023-11-28 Добавили подъезд до центра Горки с трубами, увеличили макс ограничения времени этапов.
2023-11-28 В программе езды прямо увеличили коэфф., при котором подталкиваемся хвостом (чтобы не срабатывал по неровной дороге).
2023-11-28 В программе Горка с трубами подобрали коэффициенты, добавили еще один подъезд до центра + теперь не ждем хвоста, а запускаем его и едем дальше, чтобы не терять время. Протестировали на полигоне.
2023-11-29 Немного изменены коэффициенты в Копыте, но робот еще не проходит.
2023-11-29 В Езде прямо разрешаем хвосту двигаться только через секунду после старта (чтобы он не реагировал на резкий старт робота).
2023-11-30 Настроены коэф. авто-линии.
2023-12-02 Подобраны коэфф. для Копыта.
2023-12-02 Увеличена частота кадров в сек до 25 при записи в файл (на 20 видео получается замедленным).
2024-05-18 Убрано автоматическое опускание хвоста при езде прямо.
2024-05-29 Изменено сжатие руки после замены сервы клешни.
2024-05-29 Увеличена скорость заезда на горку с трубами.
2024-05-31 В Копыте теперь поворачиваем 2 раза по 45 град.
2024-07-01 Добавлена обратная связь с передачей 2 переменных.
2024-07-02 Передача показаний датчика расстояния по обратной связи на пульт.
2024-07-04 Улучшена передача показаний датчика расстояния по обратной связи. Решена проблема с торможением серв из-за обратной связи.
2024-07-05 Radio.h разделился на робота и на пульт из-за добавления обратной связи.
2024-07-30 Сделана передача показаний датчика расстояния с выводом на экран камеры. Датчик всё время включен.
2024-07-31 Сделано включение и выключение датчика расстояния по кнопке на клавиатуре.
2024-08-02 Добавлена передача показаний датчиков цвета.
2024-08-02 Убран initCommon() из Radio.h
2024-08-03 Сделана остановка программы, если расстояние до маяка больше заданного.
2024-08-06 Добавлен таймер на 10 минут.
2024-08-07 Добавлена возможность поставить таймер на паузу. Увеличена скорость fps в 1,2 раза.
2024-08-21 Поправлены ограничения макс. углов руки и хвоста.
2024-08-28 Добавлено выставление руки под вращение среднего слоя трубок (сочетание кнопок белая + A3), увеличена скорость езды по линии, изменено количество поворотов трубы.
2024-09-26 Добавлена фаза доезда в автопрохождении усеченной пирамиды, когда робот поднялся на пирамиду.
2024-09-27 Изменены пины на выводах драйверов (теперь правый драйвер рулит моторами левой стороны робота, а левый - правой), изменено подрезание скорости моторов правой стороны.
    [Расчет робота.xlsx]
2024-09-28 Добавлена функция handToPos(), handToRideTheLine() и handToRotatePipe() работают теперь через неё.
2024-09-28 Теперь все автономные движения руки работают через handToPos().
2024-10-10 Добавлено автоподнимание руки наверх по сочетанию кнопок "синяя+зелёная", убрана доп.фаза в усечённой пирамиде.
2024-10-11 Изменена логика телеметрии.
2024-10-11 Убрано недоезжание хвоста в tailUp.
2024-10-12 Уменьшили подрезание правой оси, чтобы робот ехал прямо.
2024-11-01 Добавлен второй видеоприёмник.
2024-11-02 Добавил коммент про выбор интерпретатора питона.
2024-11-04 Выделил работу с пультом в отдельный файл.
2024-11-17 Control теперь класс (а не просто набор функций).
2024-11-17 Теперь через serial пересылаем команды не в виде строк, а как 3 байта. Добавлена временная команда езды по клавише 'x', в будущем это будет езда по линии.
2024-11-17 Добавлена езда по линии по видеокамере (еще надо отладить).
2024-11-17 Правка параметров езды по линии.
2024-11-17 Пример программы распознавания дорожных знаков.
2024-11-17 Программа "Изломанный коридор" (по дальномеру).
2024-11-17 Переименование camera.py -> main.py.
2024-11-17 Печать наименования распознанного знака.
2024-11-17 Отлажена езда по лабиринту.
2024-11-18 Отладка распознавания знаков камерой робота.
2024-11-19 Рефакторинг.
2024-11-19 Рефакторинг: выделение класса.
2024-11-19 Рефакторинг: выделение классов в отдельный файл.
2024-11-20 Подключение в программу для камеры signDetector и const.
2024-11-21 Теперь распознавание знаков можно включать по клавише.
2024-11-22 Добавил в хэлп новые клавиши.
2024-11-23 В программе подбора цветов добавлена возможность брать текущий цвет точки по клику мышки.
2024-11-23 Добавлена программа горка с трубами с автозахватом маяка. Поменены кнопки старта программ. Выставление руки на вращение трубок вынесено в Robot.ino.
2024-11-23 Заготовка программы Дорожное движение.
2024-11-23 Методы выставления руки на вращение трубок и вентилей нефти добавлены в Hand.
2024-11-24 Добавлен предпросмотр линии. Под комментарием сделана заготовка для коэффициента усиления руления на линии. Дополнен хэлп.
2024-11-24 Печать включенных режимов (программ).
2024-11-24 Таймер вынесен в отдельный класс и починены проблемы с ним.
2024-11-25 Обновлены кнопки в инструкции.
2024-11-27 Исправлено сжатие руки при взятии маяка.
    [Hand.h]
2024-11-27 В корилоре второй поворот выполняем в противоположную сторону.
2024-11-27 Изменены кнопки выставления руки на вращение вентилей нефти.
2024-11-27 Для автолинии урезали ширину окна поиска линии.
2024-11-27 Изменен COM порт подключения пульта.
2024-11-27 В коридоре подъезжаем чуть ближе к стене.
2024-11-27 На горке с трубами увеличили угол наклона при вставании на дыбы.
2024-11-27 Увеличена скорость руки и хвоста. Для руки добавлено авто выставление на верх/нижн вентили нефти.
2024-11-27 По умолчанию включаем камеру 1.
2024-11-27 Датчик расстояния теперь не выключаем, чтобы хорошо стартовало взятие банки.
2024-11-28 Чуть увеличена скорость медленной езды прямо, чтобы выбираться с мостов.
2024-11-28 Поправлены параметры сжатия руки и т.п. при автозахвате банки.
2024-11-28 Подобраны цвета знаков для камеры робота.
2024-11-28 Для верхней камеры поправили крайнее положение.
2024-11-28 По бел+C4 делаем enable датчика расстояния.
2026-09-26 Написана программа для преобразования видео (можно изменить fps)
2026-09-26 Изменены скорости манипулятора и хвоста, ограничения для сервы верхней камеры
2026-09-26 Что-то исправлено в файле расчета робота
    [Расчет робота.xlsx]
2026-09-26 Добавлена автономная программа для Доски, на которой надо балансировать
2026-09-26 Изменена подсветка таймера
2026-09-26 Добавлен режим управления только плечом (зажатая кнопка левого джойстика + левый джойстик верх/низ)
2026-09-26 Дополнено описание управления роботом
